Sense-Scape/RPI_Audio_Array/RPI_Audio_Array.kicad_pcb

## KiCad design RPI_Audio_Array.kicad_pcb (2024-02-19)

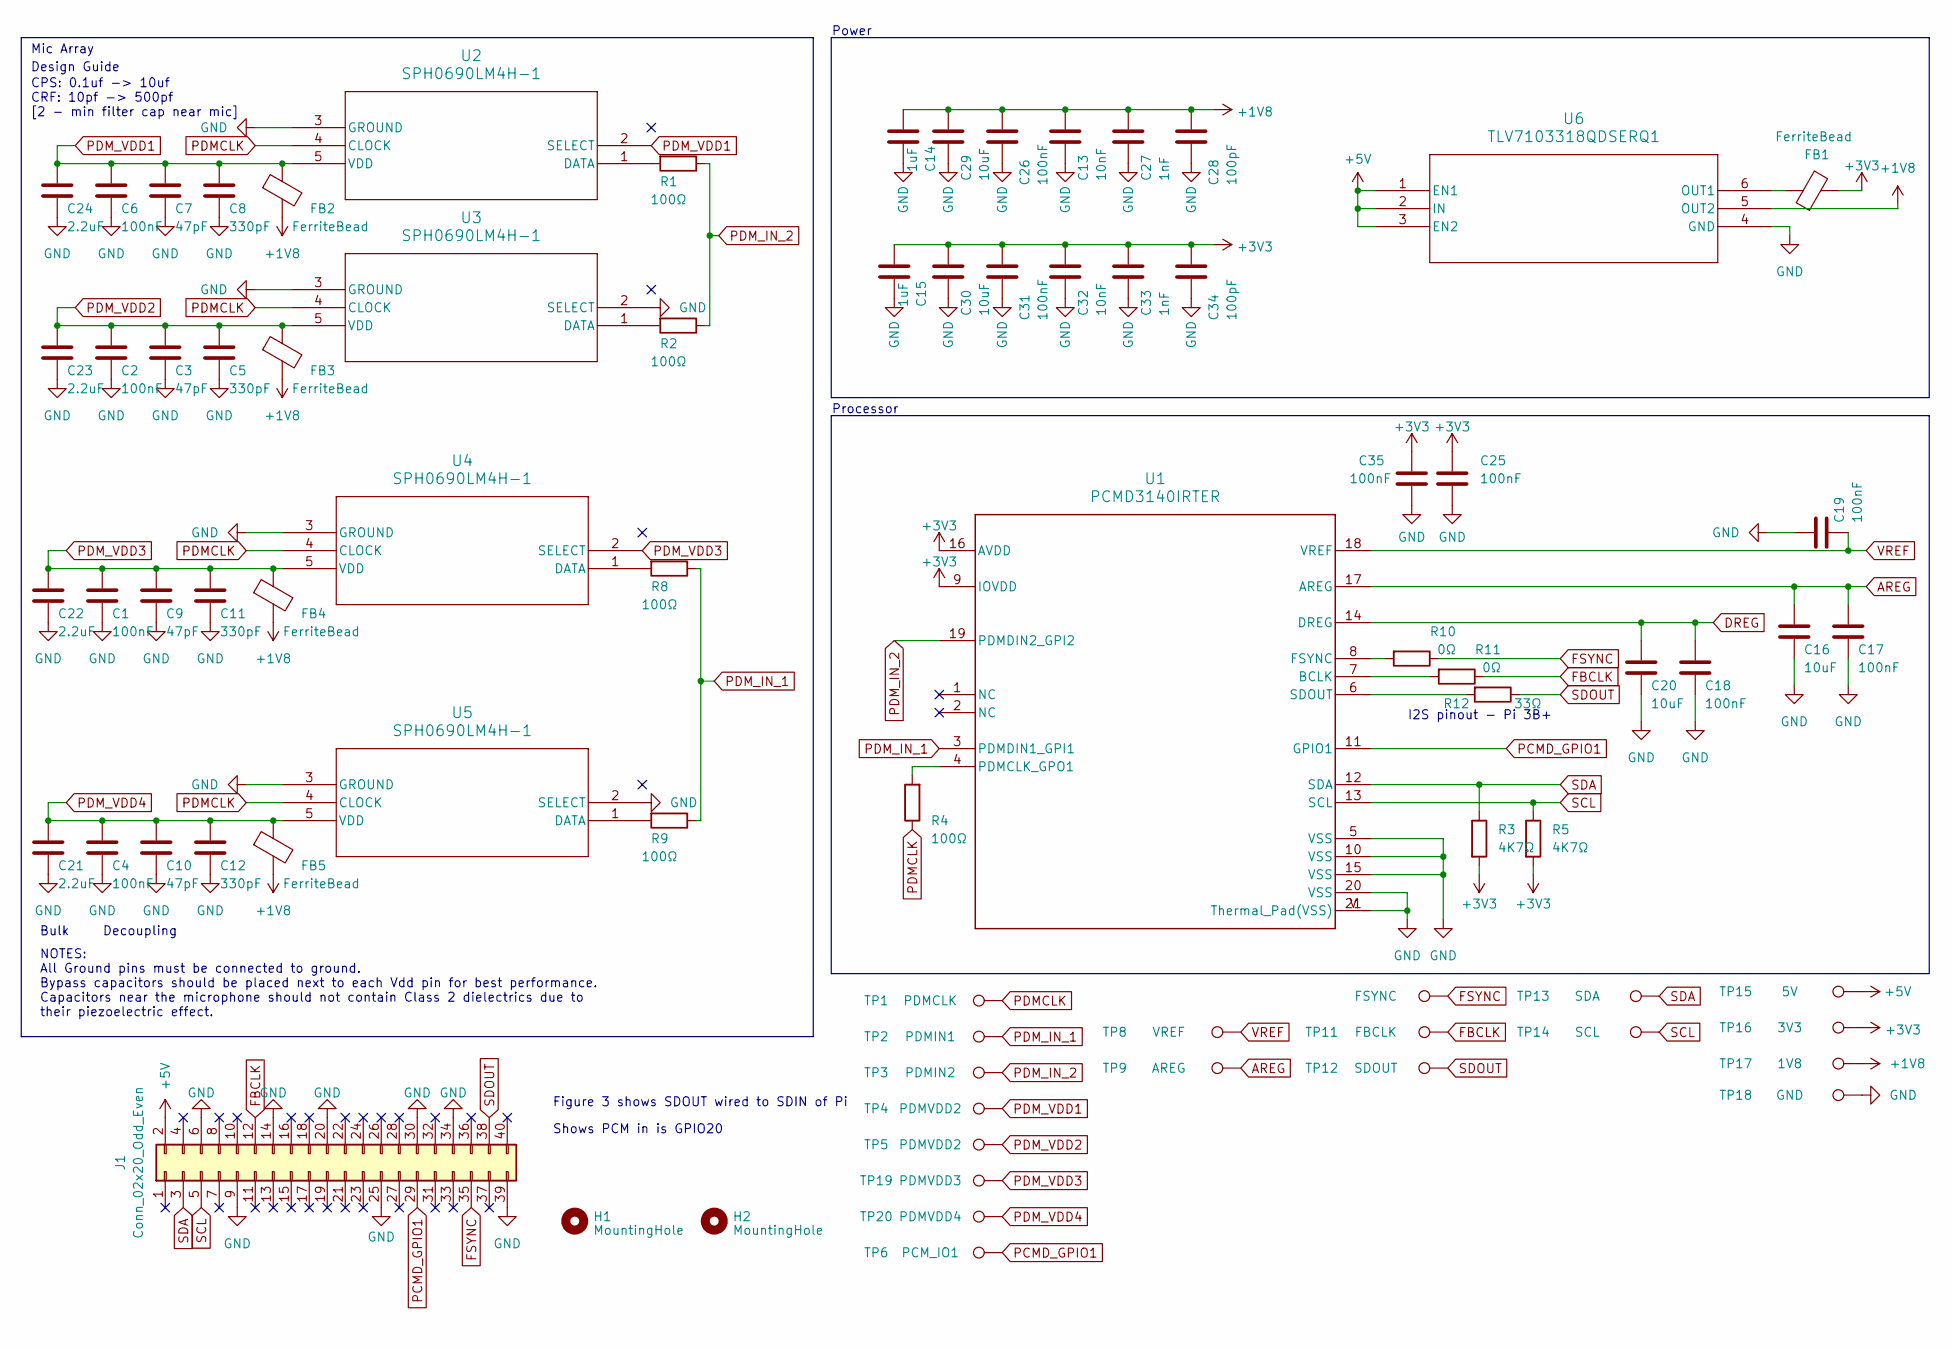
[picture p1: schematic RPI_Audio_Array.kicad_sch]

Parts:
C1, C2, C4, C6, C17, C18, C19, C25, C26, C31, C35: 100nF; C_0603_1608Metric; lcsc C14663
C3, C7, C9, C10: 47pF; C_0603_1608Metric; lcsc C1671
C5, C8, C11, C12: 330pF; C_0603_1608Metric; lcsc C1664
C13, C32: 10nF; C_0603_1608Metric; lcsc C57112
C14, C15: 1uF; C_0603_1608Metric; lcsc C15849
C16, C20: 10uF; C_0805_2012Metric; lcsc C440198
C21, C22, C23, C24: 2.2uF; C_0805_2012Metric; lcsc C377773
C27, C33: 1nF; C_0603_1608Metric; lcsc C1588
C28, C34: 100pF; C_0603_1608Metric; lcsc C14858
C29, C30: 10uF; C_1206_3216Metric; lcsc C13585
FB1, FB2, FB3, FB4, FB5: FerriteBead; L_0805_2012Metric; lcsc C1017
H1, H2: MountingHole; MountingHole_2.7mm_M2.5; lcsc DNP
J1: Conn_02x20_Odd_Even; PinSocket_2x20_P2.54mm_Vertical; lcsc DNP
R1, R2, R4, R8, R9: 100Ω; R_0603_1608Metric; lcsc C22775
R3, R5: 4K7Ω; R_0603_1608Metric; lcsc C23162
R10, R11: 0Ω; R_0603_1608Metric; lcsc C21189
R12: 33Ω; R_0603_1608Metric; lcsc C23140
TP1: PDMCLK; TestPoint_Plated_Hole_D2.0mm; lcsc DNP
TP2: PDMIN1; TestPoint_Plated_Hole_D2.0mm; lcsc DNP
TP3: PDMIN2; TestPoint_Plated_Hole_D2.0mm; lcsc DNP
TP4, TP5: PDMVDD2; TestPoint_Plated_Hole_D2.0mm; lcsc DNP
TP6: PCM_IO1; TestPoint_Plated_Hole_D2.0mm; lcsc DNP
TP8: VREF; TestPoint_Plated_Hole_D2.0mm; lcsc DNP
TP9: AREG; TestPoint_Plated_Hole_D2.0mm; lcsc DNP
TP10: FSYNC; TestPoint_Plated_Hole_D2.0mm; lcsc DNP
TP11: FBCLK; TestPoint_Plated_Hole_D2.0mm; lcsc DNP
TP12: SDOUT; TestPoint_Plated_Hole_D2.0mm; lcsc DNP
TP13: SDA; TestPoint_Plated_Hole_D2.0mm; lcsc DNP
TP14: SCL; TestPoint_Plated_Hole_D2.0mm; lcsc DNP
TP15: 5V; TestPoint_Plated_Hole_D2.0mm; lcsc DNP
TP16: 3V3; TestPoint_Plated_Hole_D2.0mm; lcsc DNP
TP17: 1V8; TestPoint_Plated_Hole_D2.0mm; lcsc DNP
TP18: GND; TestPoint_Plated_Hole_D2.0mm; lcsc DNP
TP19: PDMVDD3; TestPoint_Plated_Hole_D2.0mm; lcsc DNP
TP20: PDMVDD4; TestPoint_Plated_Hole_D2.0mm; lcsc DNP
U1: PCMD3140IRTER; RTE0020A-MFG; lcsc DNP (Not Available)
U2, U3, U4, U5: SPH0690LM4H-1; SPH0690LM4H-1_KNO; lcsc DNP (Not Available)
U6: TLV7103318QDSERQ1; DSE6_TEX; lcsc DNP (Not Available)

Connections:
+1V8: C13.1, C14.1, C26.1, C27.1, C28.1, C29.1, FB2.2, FB3.2, FB4.2, FB5.2, TP17.1, U6.5 (OUT2)
+3V3: C15.1, C25.1, C30.1, C31.1, C32.1, C33.1, C34.1, C35.1, FB1.2, R3.2, R5.2, TP16.1, U1.9 (IOVDD), U1.16 (AVDD)
+5V: J1.2, TP15.1, U6.1 (EN1), U6.2 (IN), U6.3 (EN2)
AREG: C16.1, C17.1, TP9.1, U1.17 (AREG)
DREG: C18.1, C20.1, U1.14 (DREG)
FBCLK: J1.12, R11.1, TP11.1
FSYNC: J1.35, R10.1, TP10.1
GND: C1.2, C2.2, C3.2, C4.2, C5.2, C6.2, C7.2, C8.2, C9.2, C10.2, C11.2, C12.2, C13.2, C14.2, C15.2, C16.2, C17.2, C18.2, C19.1, C20.2, C21.2, C22.2, C23.2, C24.2, C25.2, C26.2, C27.2, C28.2, C29.2, C30.2, C31.2, C32.2, C33.2, C34.2, C35.2, J1.6, J1.9, J1.14, J1.20, J1.25, J1.30, J1.34, J1.39, TP18.1, U1.5 (VSS), U1.10 (VSS), U1.15 (VSS), U1.20 (VSS), U1.21 (Thermal_Pad(VSS)), U1.V (Thermal_Pad(VSS)), U2.3 (GROUND), U3.2 (SELECT), U3.3 (GROUND), U4.3 (GROUND), U5.2 (SELECT), U5.3 (GROUND), U6.4 (GND)
unnamed: R11.2, U1.7 (BCLK)
unnamed: R10.2, U1.8 (FSYNC)
unnamed: R4.2, U1.4 (PDMCLK_GPO1)
unnamed: R12.2, U1.6 (SDOUT)
unnamed: R1.2, U2.1 (DATA)
unnamed: R2.2, U3.1 (DATA)
unnamed: R8.2, U4.1 (DATA)
unnamed: R9.2, U5.1 (DATA)
unnamed: FB1.1, U6.6 (OUT1)
PCMD_GPIO1: J1.29, TP6.1, U1.11 (GPIO1)
PDMCLK: R4.1, TP1.1, U2.4 (CLOCK), U3.4 (CLOCK), U4.4 (CLOCK), U5.4 (CLOCK)
PDM_IN_1: R8.1, R9.1, TP2.1, U1.3 (PDMDIN1_GPI1)
PDM_IN_2: R1.1, R2.1, TP3.1, U1.19 (PDMDIN2_GPI2)
PDM_VDD1: C6.1, C7.1, C8.1, C24.1, FB2.1, TP4.1, U2.2 (SELECT), U2.5 (VDD)
PDM_VDD2: C2.1, C3.1, C5.1, C23.1, FB3.1, TP5.1, U3.5 (VDD)
PDM_VDD3: C1.1, C9.1, C11.1, C22.1, FB4.1, TP19.1, U4.2 (SELECT), U4.5 (VDD)
PDM_VDD4: C4.1, C10.1, C12.1, C21.1, FB5.1, TP20.1, U5.5 (VDD)
SCL: J1.5, R5.1, TP14.1, U1.13 (SCL)
SDA: J1.3, R3.1, TP13.1, U1.12 (SDA)
SDOUT: J1.38, R12.1, TP12.1
VREF: C19.2, TP8.1, U1.18 (VREF)

Notes on the sheet:
Bulk
I2S pinout - Pi 3B+
CPS: 0.1uf -> 10uf CRF: 10pf -> 500pf [2 - min filter cap near mic]
Mic Array
Power
Figure 3 shows SDOUT wired to SDIN of Pi
Shows PCM in is GPIO20
Decoupling
NOTES: All Ground pins must be connected to ground. Bypass capacitors should be placed next to each Vdd pin for best performance. Capacitors near the microphone should not contain Class 2 dielectrics due to their piezoelectric effect.
Design Guide
Processor

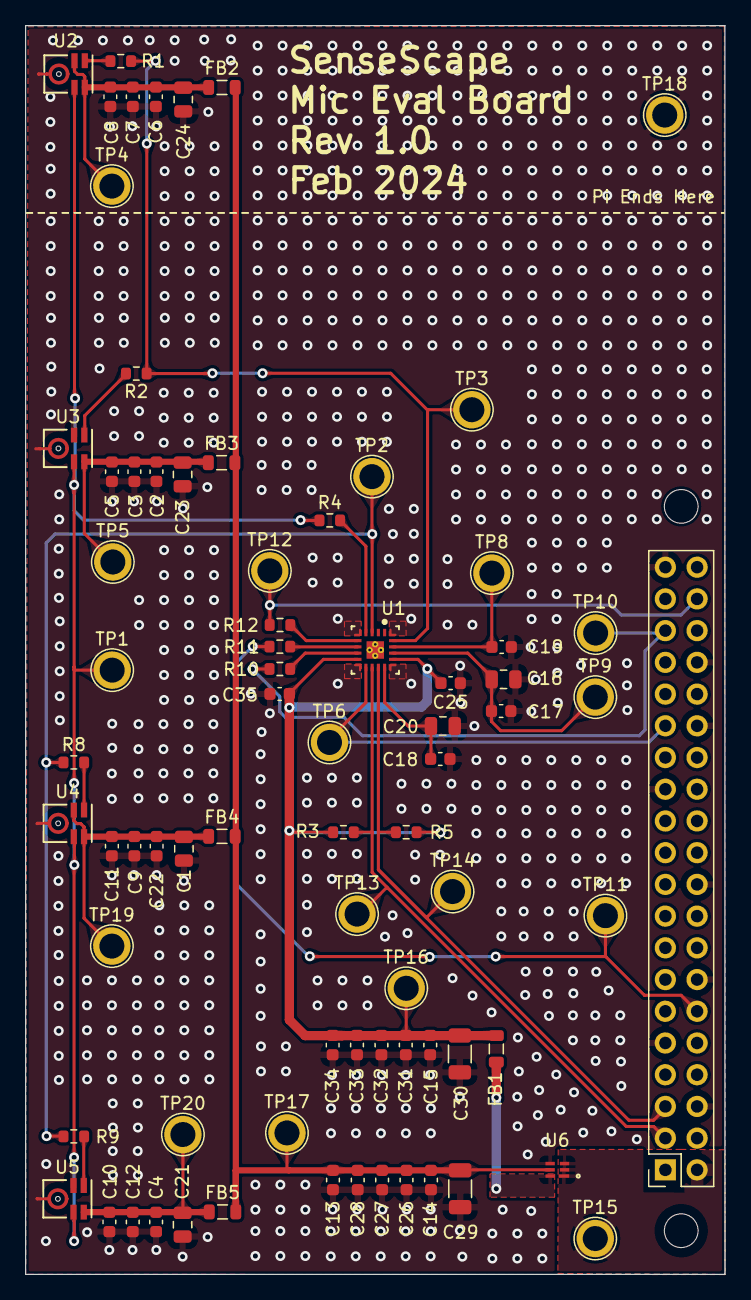
[picture p2: board RPI_Audio_Array.kicad_pcb from above]

Board: 2 copper layers, 56.0 x 100.0 mm, 78 parts (0 on the bottom side), 29 nets.
