Sense-Scape/RPI_Audio_Array/(commit log)

2024-02-07 Feat: Fist commit
    [RPI_Audio_Array.kicad_pcb, RPI_Audio_Array.kicad_sch]
2024-02-11 Fix: Schemtatic fixes
    [RPI_Audio_Array.kicad_sch]
2024-02-11 Chore: Updating PCB
    [RPI_Audio_Array.kicad_sch]
2024-02-14 Fix: making further changes to bugs in schematic
    [RPI_Audio_Array.kicad_sch]
2024-02-15 Fix: Removing extra cap
    [RPI_Audio_Array.kicad_sch]
2024-02-17 Feat: Rerouting PCB
    [RPI_Audio_Array.kicad_pcb]
2024-02-17 Feat: adding more routing
    [RPI_Audio_Array.kicad_pcb]
2024-02-18 Chore: To fix drc issues
    [RPI_Audio_Array.kicad_pcb, RPI_Audio_Array.kicad_sch]
2024-02-19 Feat: Resolving all DRC warnings
    [RPI_Audio_Array.kicad_pcb, RPI_Audio_Array.kicad_sch]
2024-02-19 updated PCB and schematic for review
    [RPI_Audio_Array.kicad_pcb, RPI_Audio_Array.kicad_sch, bom.csv, designators.csv, positions.csv]
